Medokin8/Projekt_Zespolowy_Robot_Zwiadowczy/Konstruktorzy/Schematy/gąsienica.png

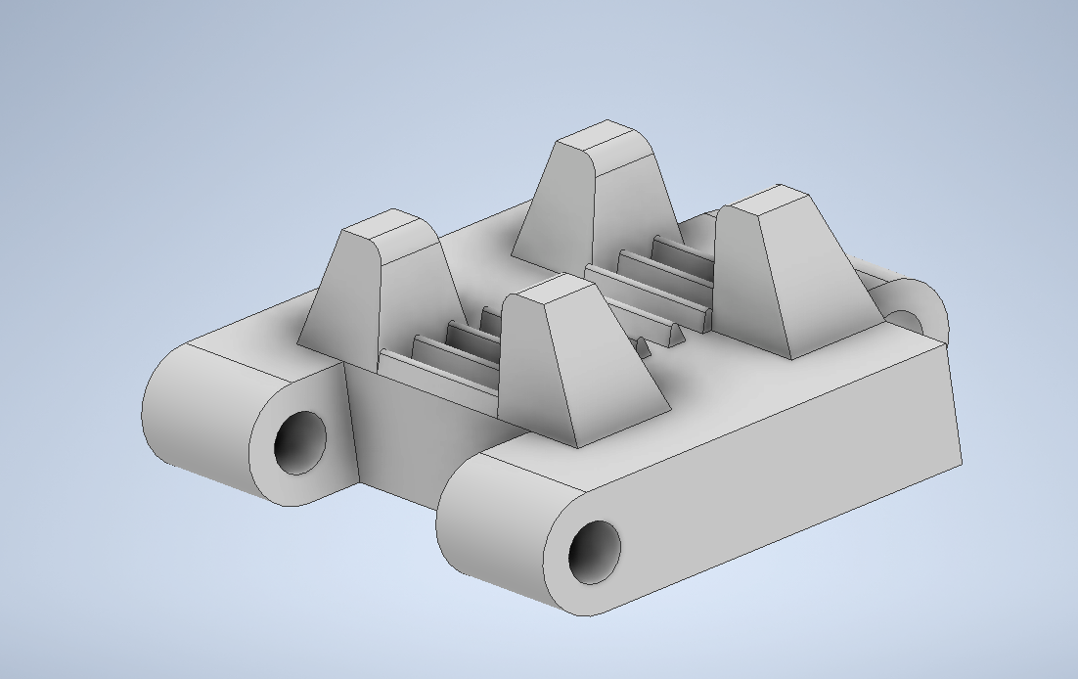
Konstruktorzy/Schematy/gąsienica.png
