Medokin8/Projekt_Zespolowy_Robot_Zwiadowczy/Konstruktorzy/Zdjęcia/gora.jpg

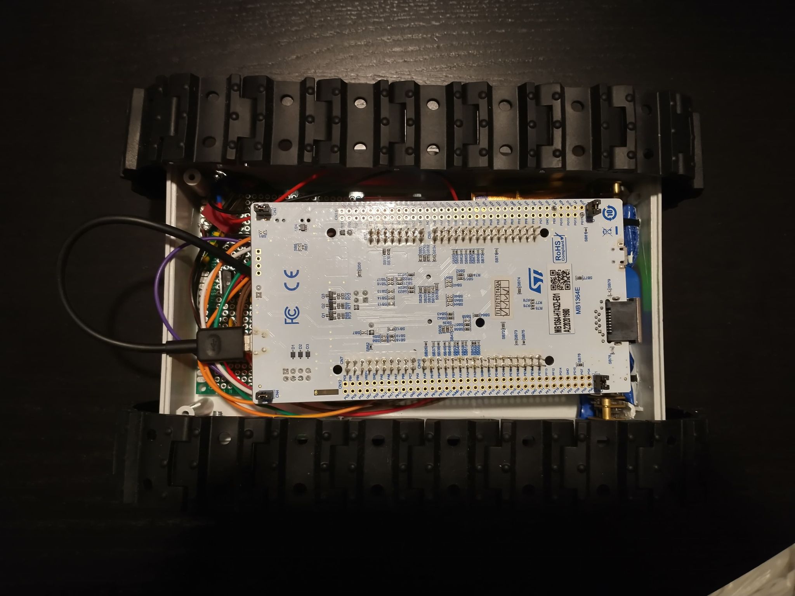
Konstruktorzy/Zdjęcia/gora.jpg
