Medokin8/Projekt_Zespolowy_Robot_Zwiadowczy/README.md

#Projekt_Zespolowy_Robot_Zwiadowczy
Repozytorium dla Projektu Zespołowego - Robot Zwiadowczy

Link do strony, poświęconej projektowi: http://panamint.kcir.pwr.edu.pl/~niwin/
