Medokin8/Projekt_Zespolowy_Robot_Zwiadowczy/Konstruktorzy/Raporty/raport_konstrukcja_1.pdf

Projekt zespołowy - Robot zwiadowczy

Sekcja konstrukcyjna

## Robot zwiadowczy - Pierwszy kamień milowy

(28.03.22)

Gerard Gawłowski, Nikodem Iwin

Prowadzący:
dr hab. inż Elżbieta Roszkowska

Katedra Cybernetyki i Robotyki Wydziału Elektroniki, Fotoniki i Mikrosystemów
Politechniki Wrocławskiej

27 marca 2022

## Spis treści

1 Charakterystyka kamienia milowego | 1
2 Specyfikacja finalnego produktu | 1
3 Zakup części | 3

i

## 1 Charakterystyka kamienia milowego

Pierwszym kamieniem milowym dla naszej sekcji było utworzenie prototypu strony internetowej i repozytorium na platformie GitHub poświęconej projektowi oraz zakup potrzebnych części do realizacji projektu.

## 2 Specyfikacja finalnego produktu

### 2.1 Prototyp strony WWW

Prototyp strony został napisany w języku HTML i wygląda jak na rysunku 1. Wraz z rozwojem projektu strona będzie ulegać zmianom i korektom.

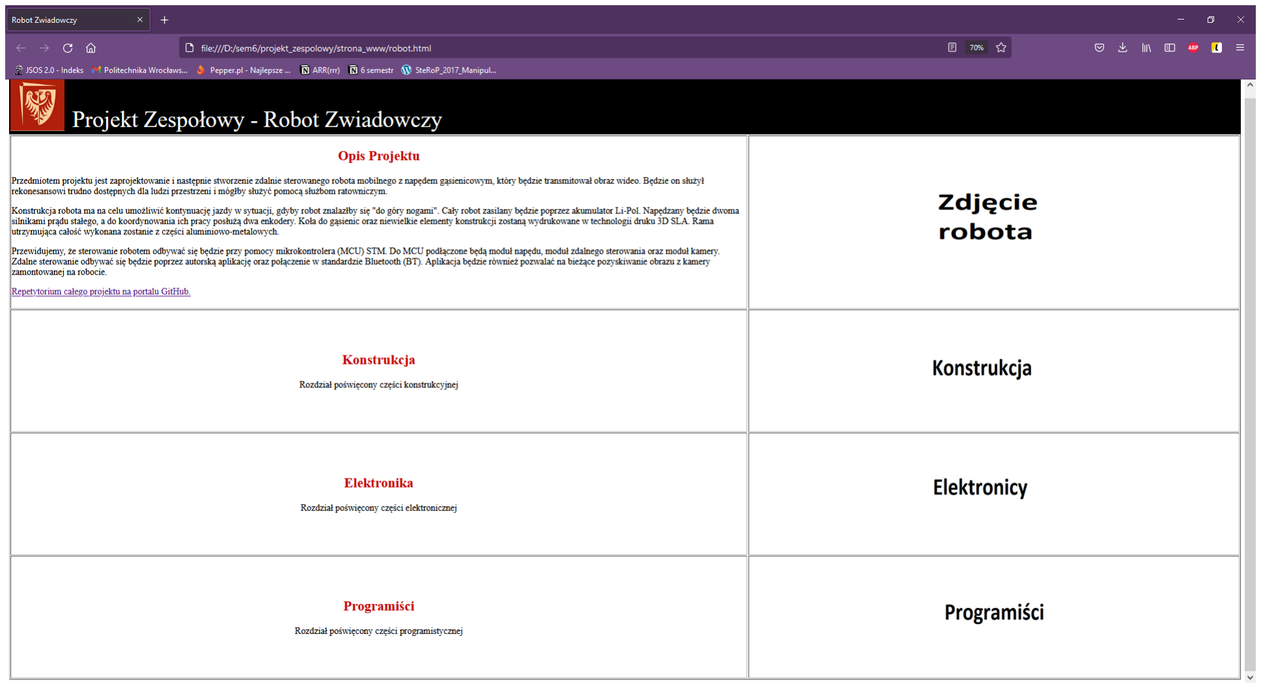
[picture p11: figure]

Rysunek 1: Prototyp strony WWW.

W zamyśle będzie to strona, która ogólnie przedstawi projekt w zakresie konstrukcji, elektorniki oraz programowania. Oprócz krótkich opisów oraz obrazów będzie również hiperłącze do repozytorium.

### 2.2 Repozytorium na platformie GitHub

Repozytorium na GitHub-ie zostało założone oraz podzielone kolejno na:

- main
- Elektronicy

– Oprogramowanie

– Raporty

– Schematy

– Zdjęcia

- Konstruktorzy

– Oprogramowanie

– Raporty

– Schematy

– Zdjęcia

- Programiści

– Oprogramowanie

– Raporty

– Schematy

– Zdjęcia

## 3 Zakup części

Zgodnie z ”Opisem Projektu” zostało złożone zamówienie na części, które zostały wy-kazane w poniższej tabeli numer 1. Obecnie oczekujemy an części, a po ich otrzymaniu rozpoczynamy dalsze prace.

Tabela kosztów
Przedmiot | ilość | cena netto (za sztukę) | cenna brutto (za sztukę) | sklep
Akumulator Li-Pol (https://botland.com.pl/akumulatory-li-pol-3s-111v-/8320-pakiet-li-pol-redox-900mah-20c-3s-111v-5903754000508.html) | 1 | 30,81 | 37,90 | Botland
Silniki (https://botland.com.pl/silniki-dc-micro-z-przekladnia/5097-silnik-hpcb-1501-obustronny-wal-pololu-3076-5904422306281.html) | 2 | 63,33 | 77,90 | Botland
Kamera (https://botland.com.pl/kamery-do-arduino-i-raspberry-pi/4937-modul-kamery-ov2640-2mpx-1622x1200px-60fps-waveshare-8532-5904422300388.html) | 1 | 47,15 | 58,00 | Botland
Gąsienice (https://botland.com.pl/makeblock-akcesoria/10560-makeblock-87050-gasienica-40szt-5904422316433.html) | 1 | 43,17 | 59,00 | Botland
Moduł Bluetooth (https://botland.com.pl/moduly-bluetooth/6818-modul-bluetooth-hc-06-zs-040.html) | 1 | 34,88 | 42,90 | Botland
Mikrokontorler STM32 (https://botland.com.pl/stm32-nucleo/3499-stm32-nucleo-f334r8-stm32f334r8t6-arm-cortex-m4-5904422364922.html) | 1 | 56,83 | 69,90 | Botland
Enkodery (https://botland.com.pl/enkodery/4884-zestaw-enkoderow-magnetycznych-do-micro-silnikow-pololu-kompatybilne-z-hpcb-27-18v-2-szt-pololu-3081-5904422309763.html) | 1 | 36,50 | 44,90 | Botland
Obudowa plastikowa (https://botland.com.pl/obudowy/5956-obudowa-plastikowa-kradex-z72j-179x102x49mm-jasna-5904422302177.html) | 1 | 13,74 | 16,90 | Botland
Cena łaczna | 389,74 | 485,30

Tabela 1: Tabela kosztów
