Medokin8/Projekt_Zespolowy_Robot_Zwiadowczy/Programisci/Raporty/raport_programisci_1.pdf

Projekt zespołowy - Robot zwiadowczy

Sekcja programistyczna

## Robot zwiadowczy - Pierwszy kamień milowy(28.03.2022)

Jacek Grzegorzewski, Dominik Polak

Prowadzący:
dr hab. inż Elżbieta Roszkowska

Katedra Cybernetyki i Robotyki Wydziału Elektroniki, Fotoniki i Mikrosystemów
Politechniki Wrocławskiej

28 marca 2022

## Spis treści

1 Charakterystyka kamienia milowego | 1
2 Specyfikacja finalnego produktu | 1

i

## 1 Charakterystyka kamienia milowego

Pierwszym kamieniem milowym dla naszej sekcji było stworzenie schematu do sprawozdań w Latexie.

## 2 Specyfikacja finalnego produktu

Schemat został stworzony w systemie Latex. Pierwsza strona została przedstawiona na rysunku 1, natomiast na stronie przedstawionej na rysunku2 został przedstawiony wstępny spis treści pokazujący co będzie zawierało dane sprawozdanie.

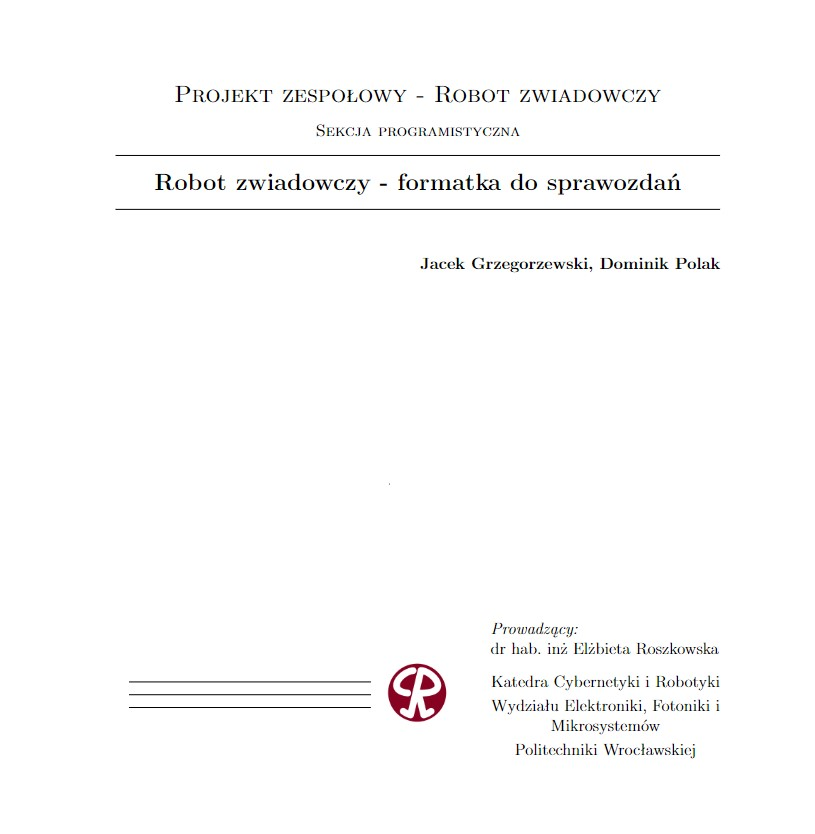
[picture p28: figure]

Rysunek 1: Strona główna sprawozdania

1

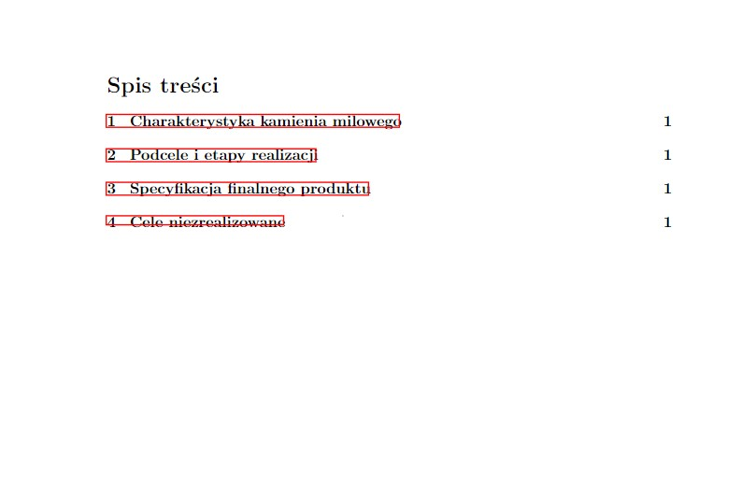
[picture p29: figure]

Rysunek 2: Strona 2, spis treści

## Literatura

2
