Medokin8/Projekt_Zespolowy_Robot_Zwiadowczy/Elektronicy/Zdjęcia/kod.png

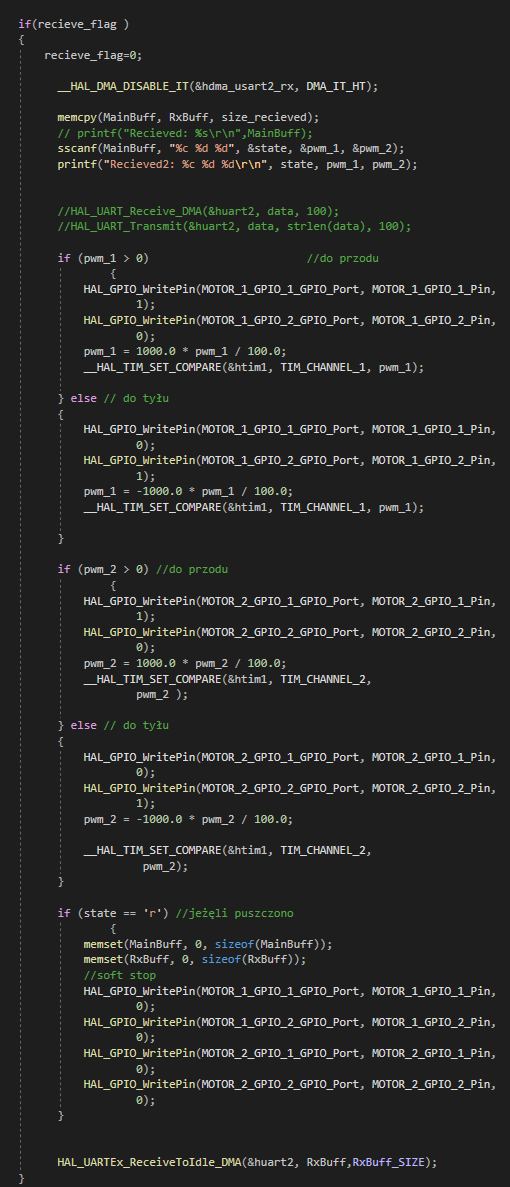
Elektronicy/Zdjęcia/kod.png
