Medokin8/Projekt_Zespolowy_Robot_Zwiadowczy/Elektronicy/Zdjęcia/schemat.png

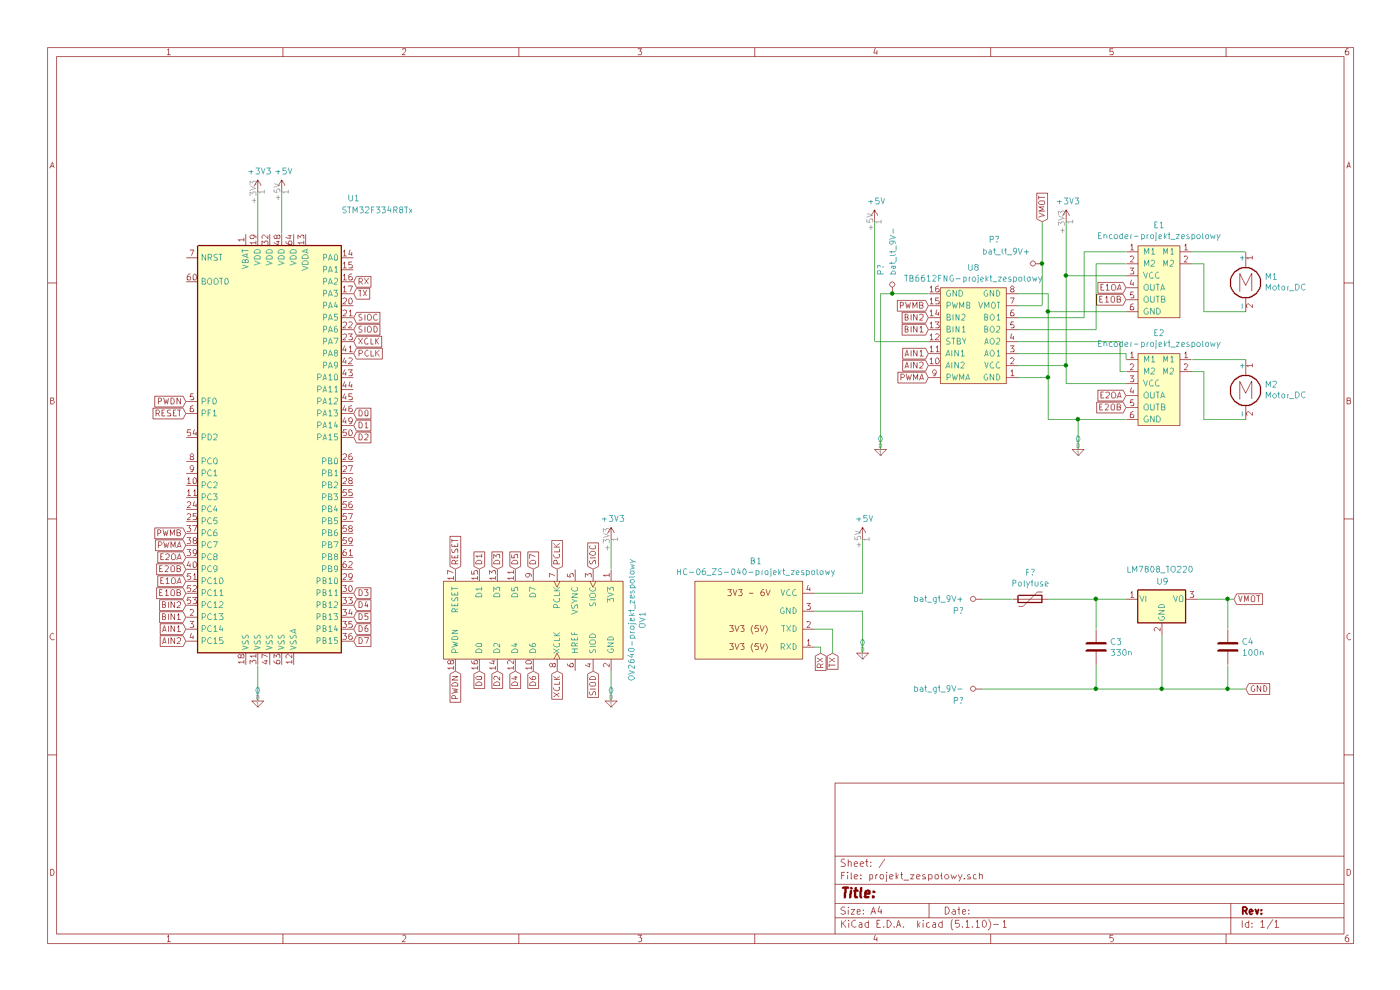
Elektronicy/Zdjęcia/schemat.png
