Medokin8/Projekt_Zespolowy_Robot_Zwiadowczy/Konstruktorzy/Schematy/kolo_napedowe_rysunek.png

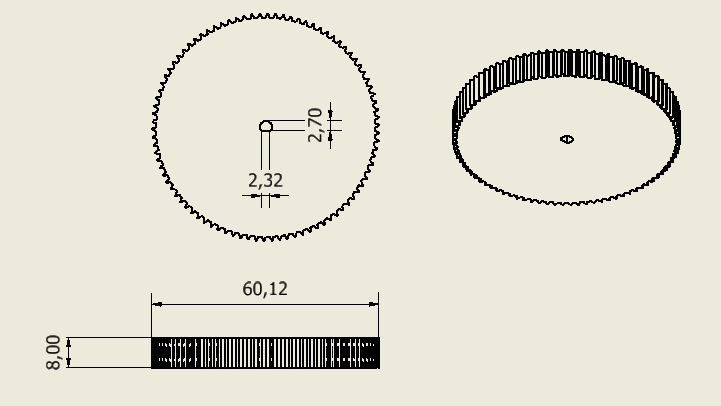
Konstruktorzy/Schematy/kolo_napedowe_rysunek.png
