Medokin8/Projekt_Zespolowy_Robot_Zwiadowczy/Konstruktorzy/Zdjęcia/284127700_5588591894509014_6389099319705223825_n.jpg

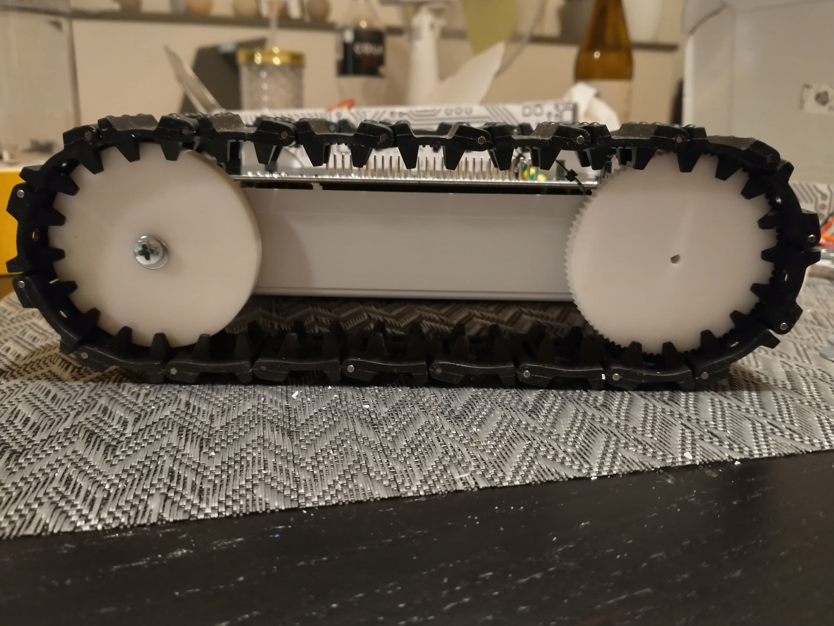
Konstruktorzy/Zdjęcia/284127700_5588591894509014_6389099319705223825_n.jpg
