Medokin8/Projekt_Zespolowy_Robot_Zwiadowczy/Konstruktorzy/Zdjęcia/284360030_1320538168766506_1794663341702950426_n.jpg

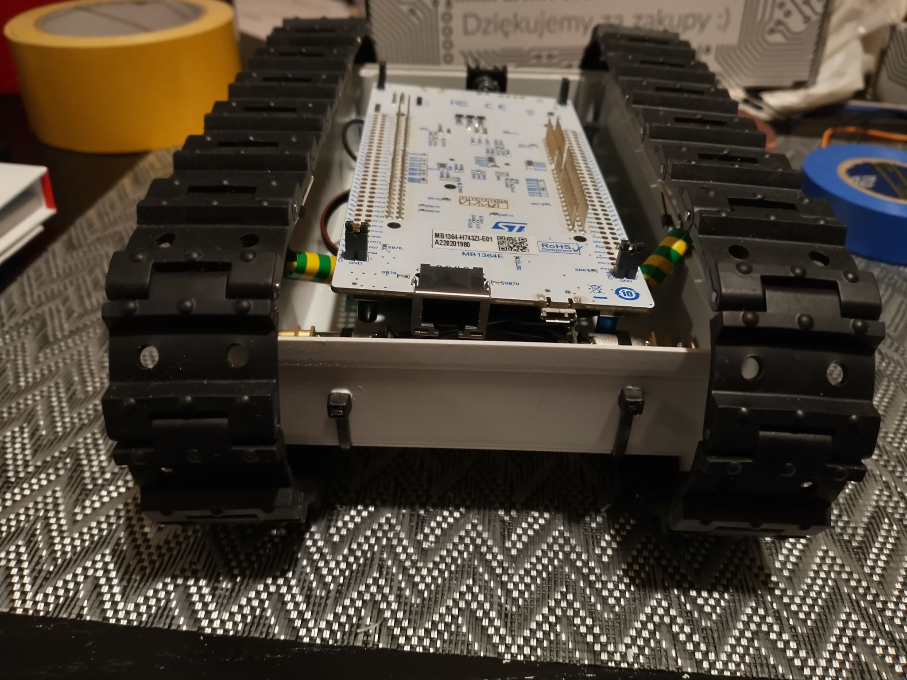
Konstruktorzy/Zdjęcia/284360030_1320538168766506_1794663341702950426_n.jpg
