Medokin8/Projekt_Zespolowy_Robot_Zwiadowczy/Konstruktorzy/Zdjęcia/284587400_364073168927964_801465958037753623_n.jpg

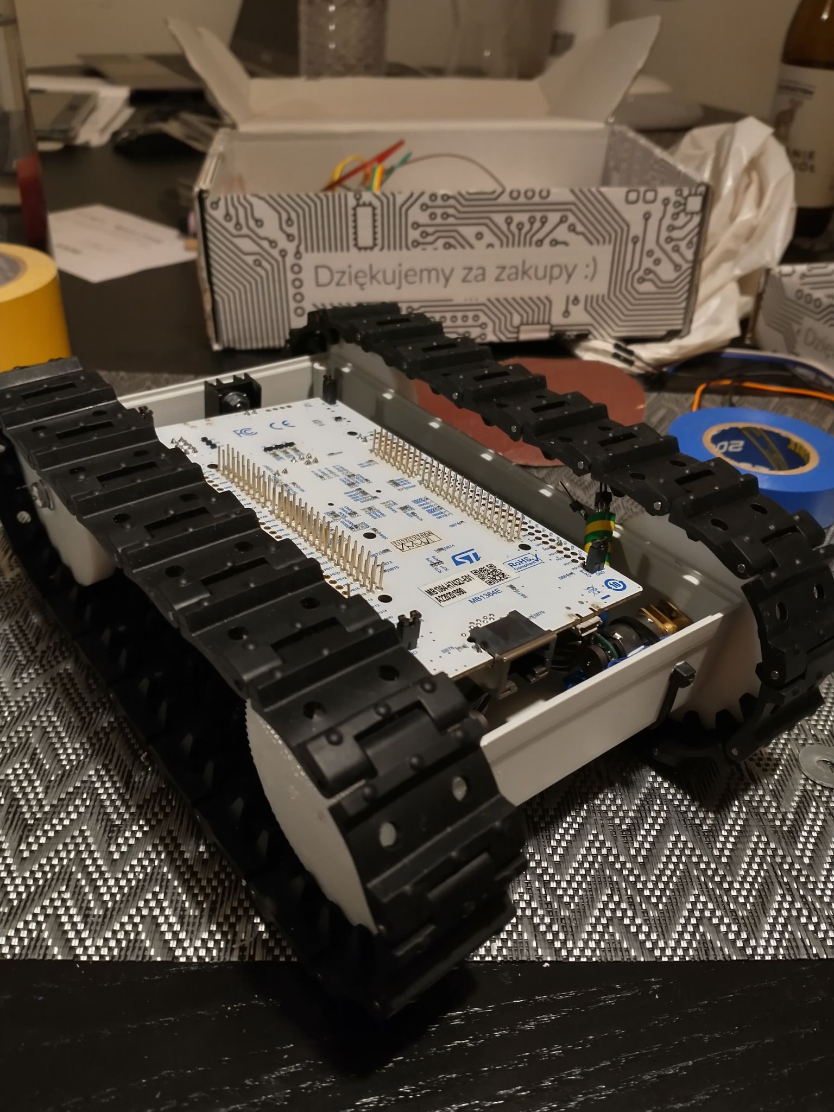
Konstruktorzy/Zdjęcia/284587400_364073168927964_801465958037753623_n.jpg
