Medokin8/Projekt_Zespolowy_Robot_Zwiadowczy/Konstruktorzy/Zdjęcia/bok.jpg

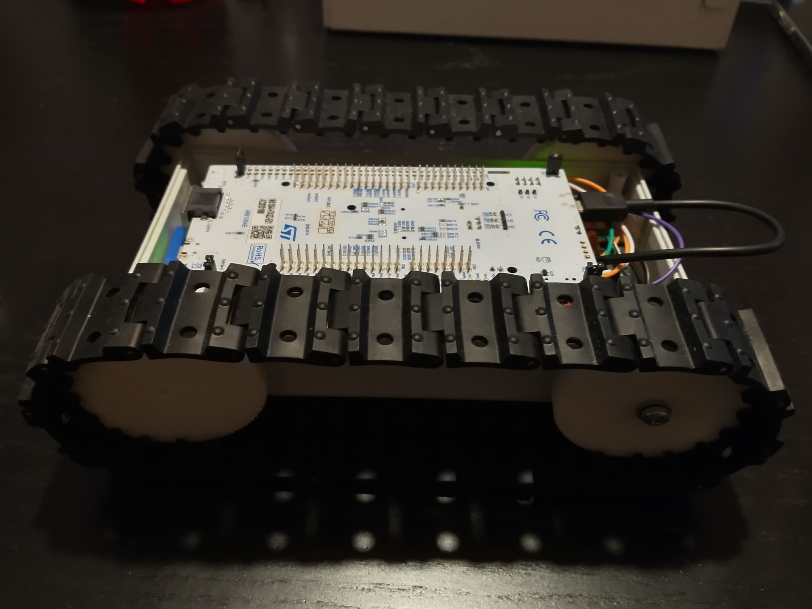
Konstruktorzy/Zdjęcia/bok.jpg
