Medokin8/Projekt_Zespolowy_Robot_Zwiadowczy/Konstruktorzy/Zdjęcia/budowa.jpg

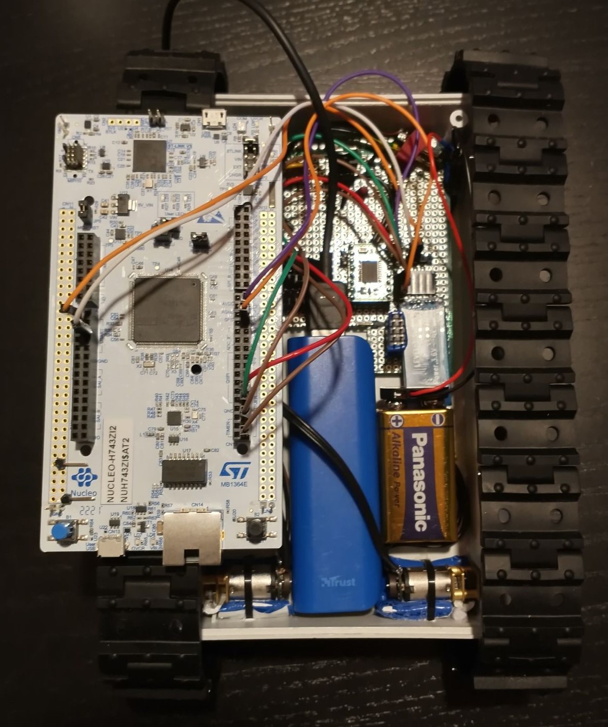
Konstruktorzy/Zdjęcia/budowa.jpg
