Medokin8/Projekt_Zespolowy_Robot_Zwiadowczy/Konstruktorzy/Zdjęcia/budowa_przed.jpg

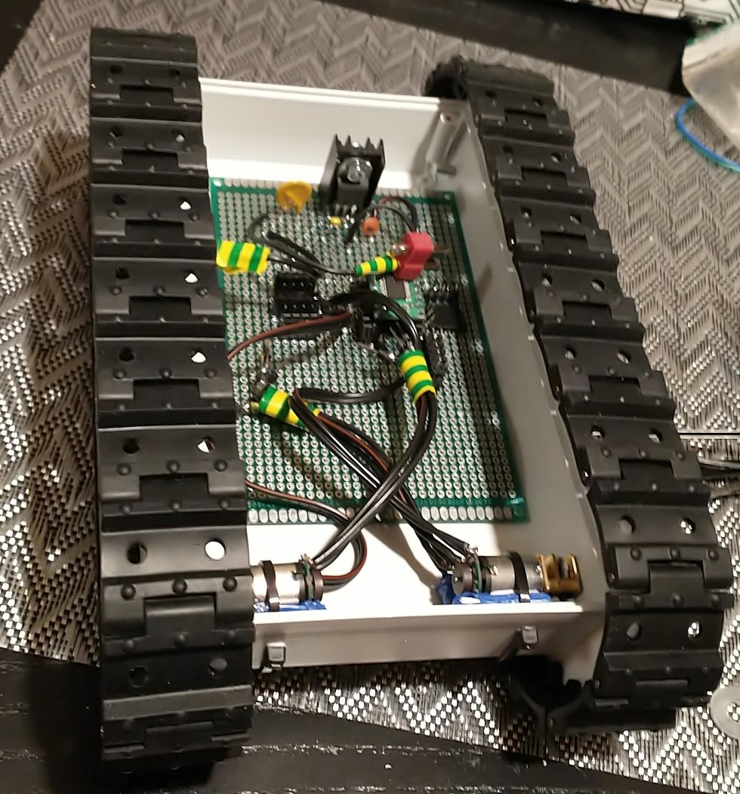
Konstruktorzy/Zdjęcia/budowa_przed.jpg
