Medokin8/Projekt_Zespolowy_Robot_Zwiadowczy/Konstruktorzy/Zdjęcia/płytka.jpg

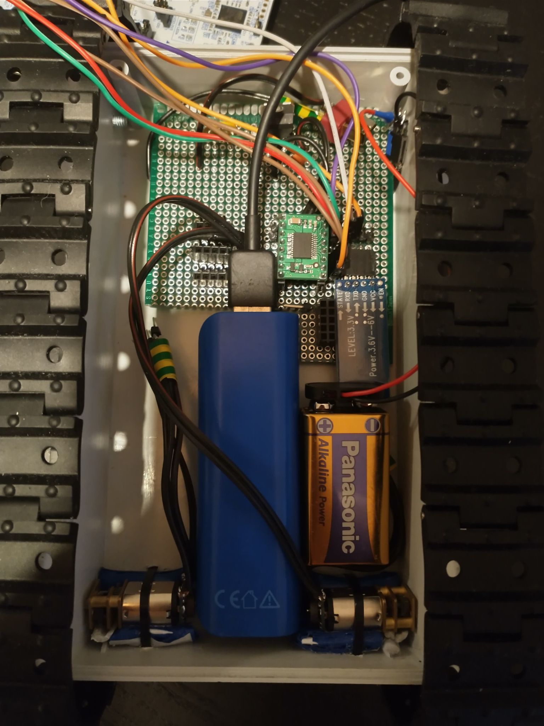
Konstruktorzy/Zdjęcia/płytka.jpg
