Medokin8/Projekt_Zespolowy_Robot_Zwiadowczy/Konstruktorzy/Zdjęcia/s1.PNG

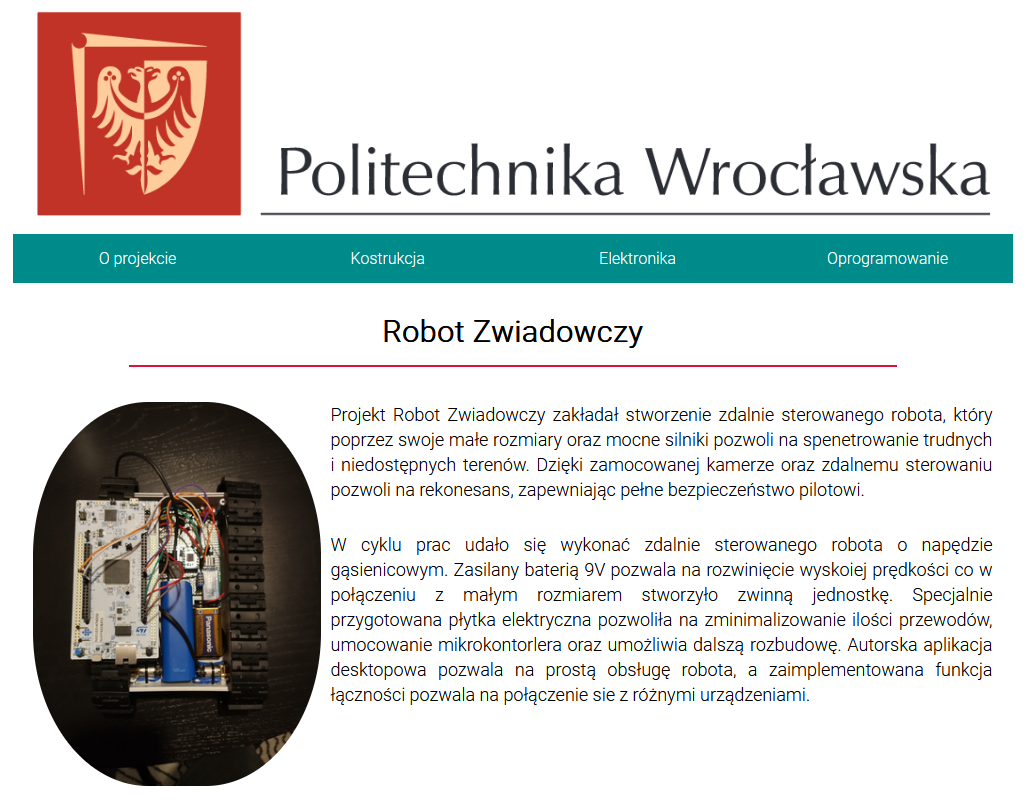
Konstruktorzy/Zdjęcia/s1.PNG
