Medokin8/Projekt_Zespolowy_Robot_Zwiadowczy/Konstruktorzy/Zdjęcia/s2.PNG

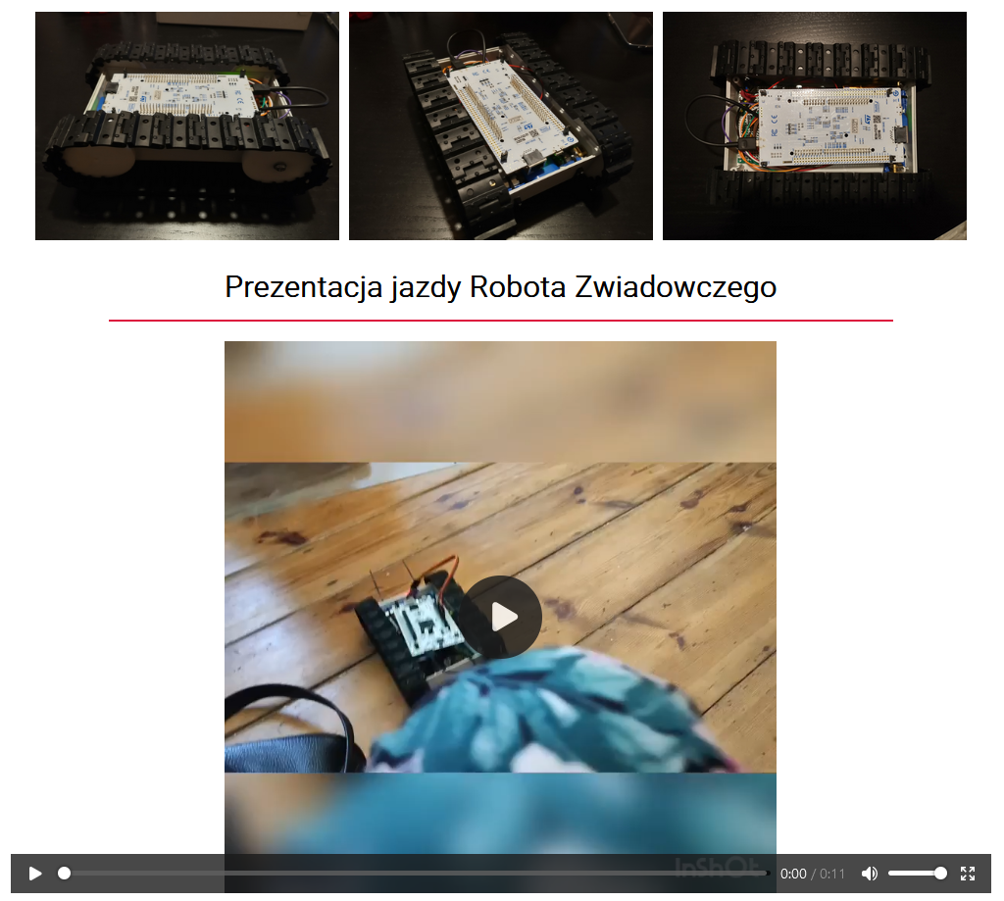
Konstruktorzy/Zdjęcia/s2.PNG
