Medokin8/Projekt_Zespolowy_Robot_Zwiadowczy/Konstruktorzy/Zdjęcia/s3.PNG

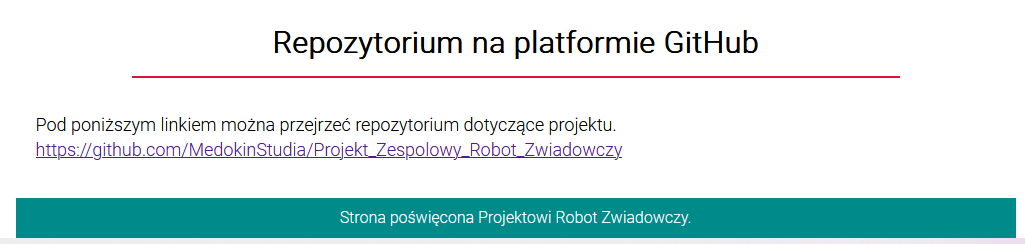
Konstruktorzy/Zdjęcia/s3.PNG
