Medokin8/Projekt_Zespolowy_Robot_Zwiadowczy/Konstruktorzy/Zdjęcia/s4.PNG

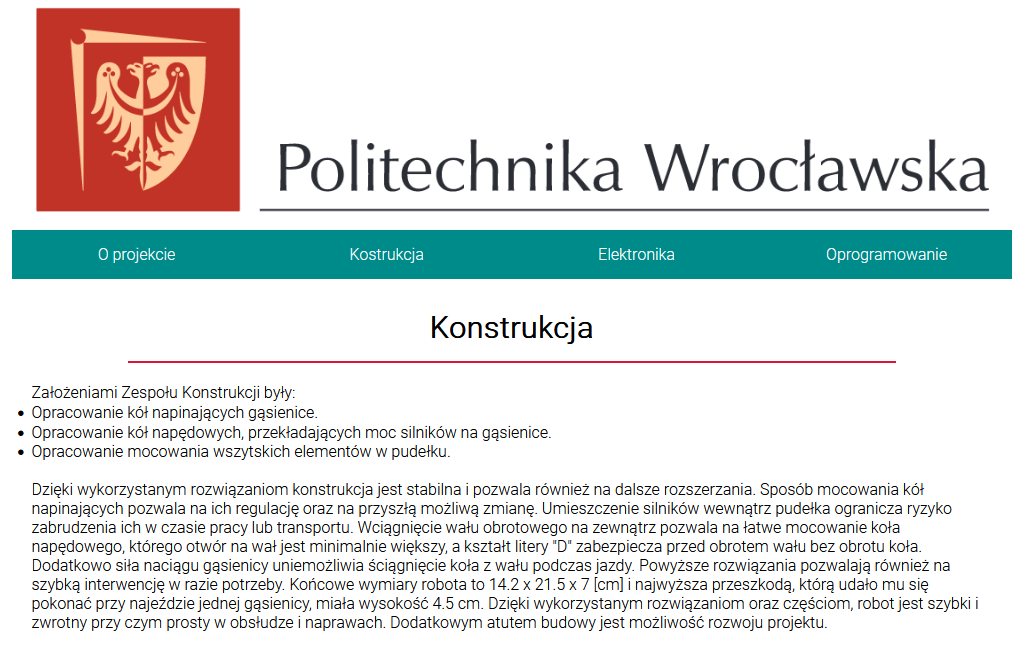
Konstruktorzy/Zdjęcia/s4.PNG
