Medokin8/Projekt_Zespolowy_Robot_Zwiadowczy/Konstruktorzy/Zdjęcia/s5.PNG

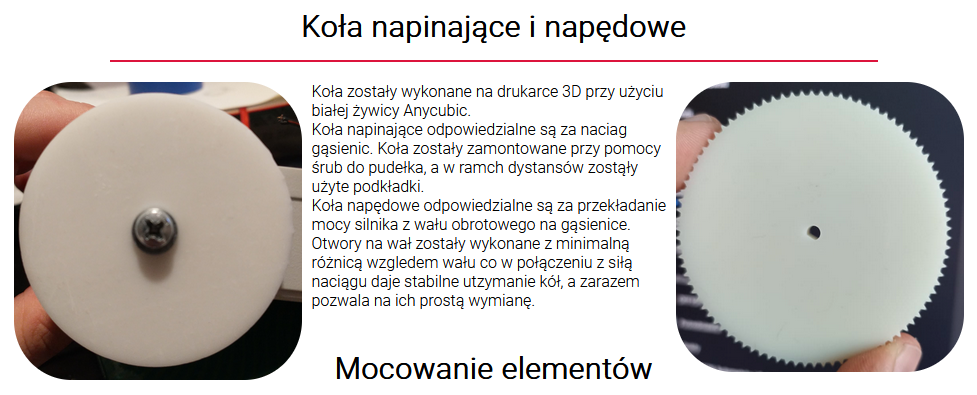
Konstruktorzy/Zdjęcia/s5.PNG
