Medokin8/Projekt_Zespolowy_Robot_Zwiadowczy/Konstruktorzy/Zdjęcia/s6.PNG

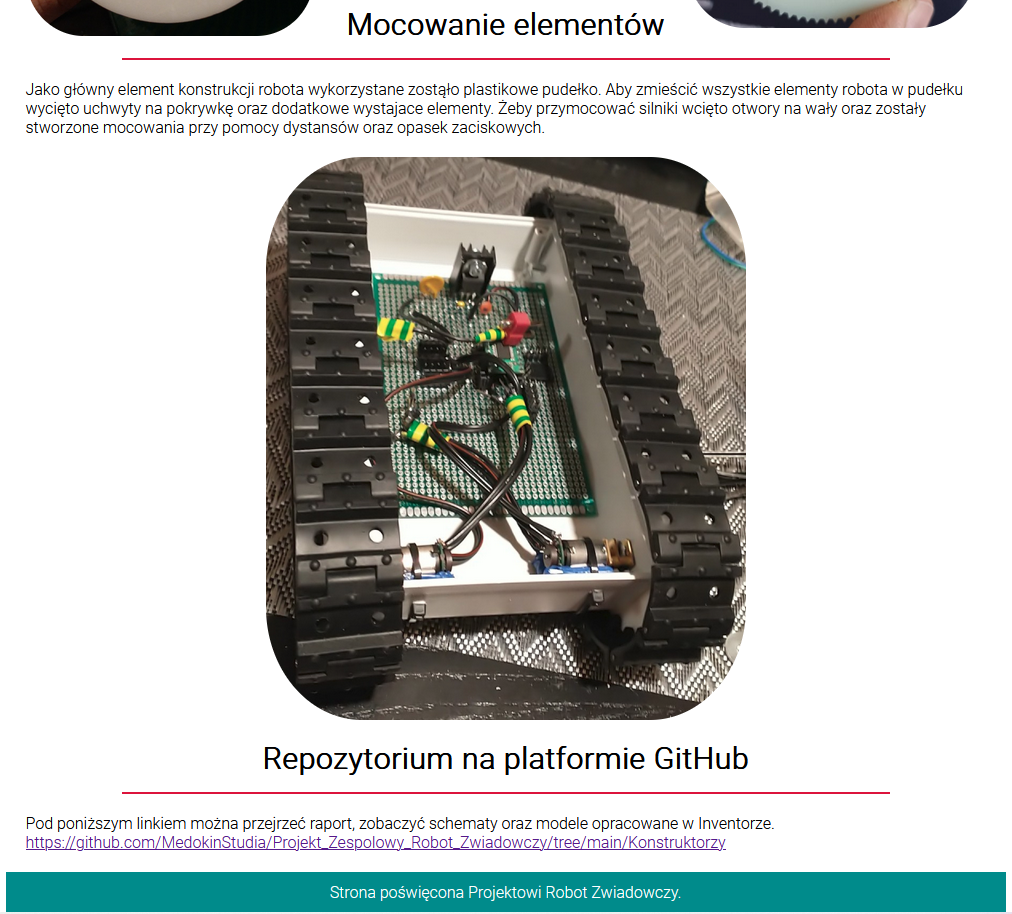
Konstruktorzy/Zdjęcia/s6.PNG
