Medokin8/Projekt_Zespolowy_Robot_Zwiadowczy/Konstruktorzy/Zdjęcia/s7.PNG

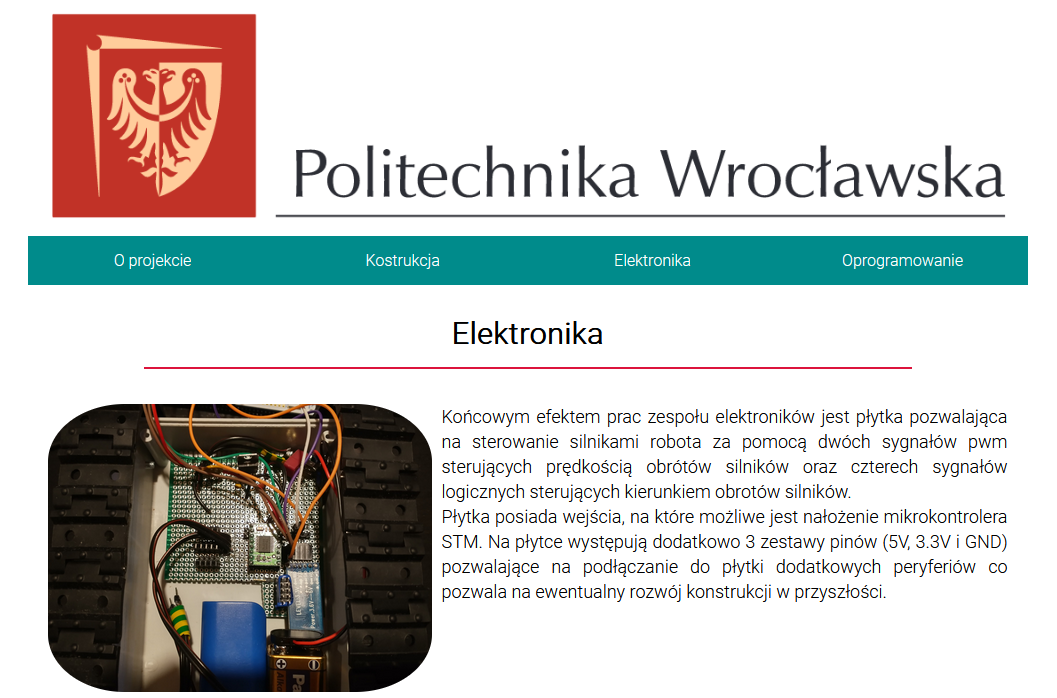
Konstruktorzy/Zdjęcia/s7.PNG
