Medokin8/Projekt_Zespolowy_Robot_Zwiadowczy/Konstruktorzy/Zdjęcia/s8.PNG

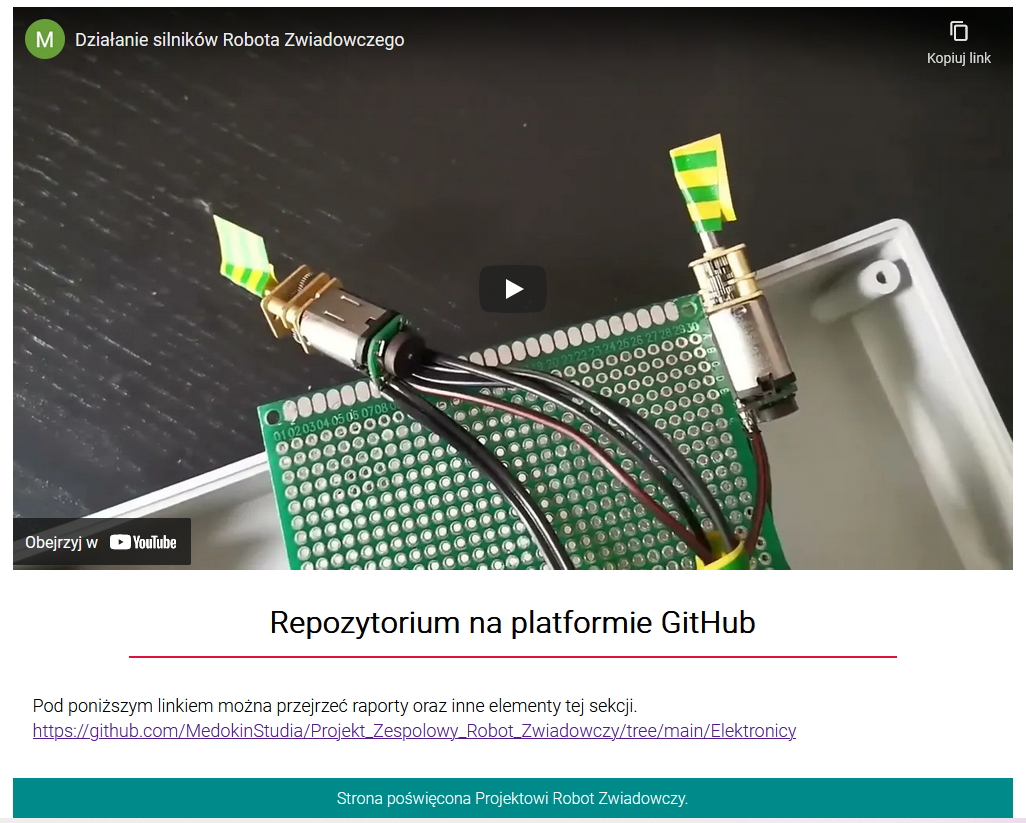
Konstruktorzy/Zdjęcia/s8.PNG
