Medokin8/Projekt_Zespolowy_Robot_Zwiadowczy/Konstruktorzy/Zdjęcia/s9.PNG

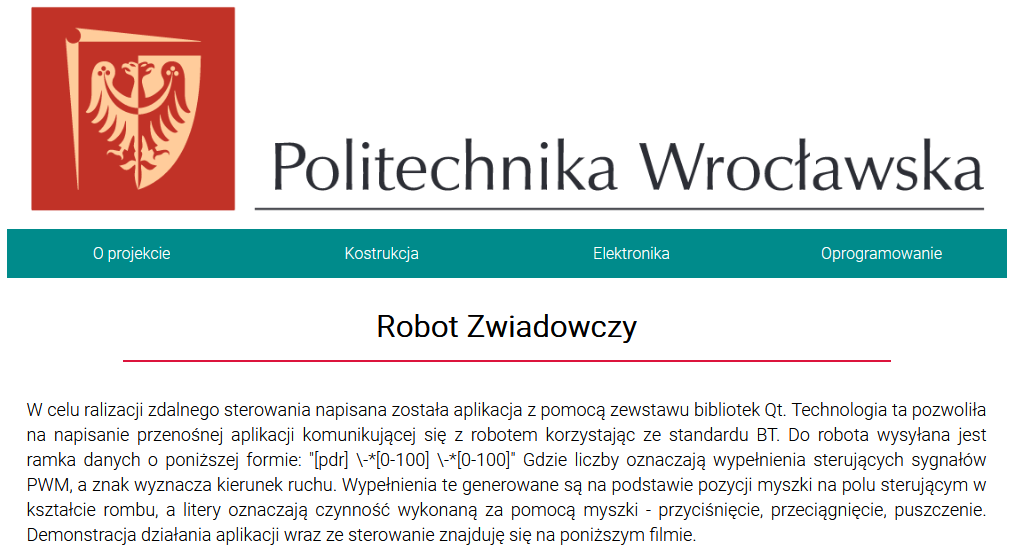
Konstruktorzy/Zdjęcia/s9.PNG
