Medokin8/Projekt_Zespolowy_Robot_Zwiadowczy/Konstruktorzy/Zdjęcia/s10.PNG

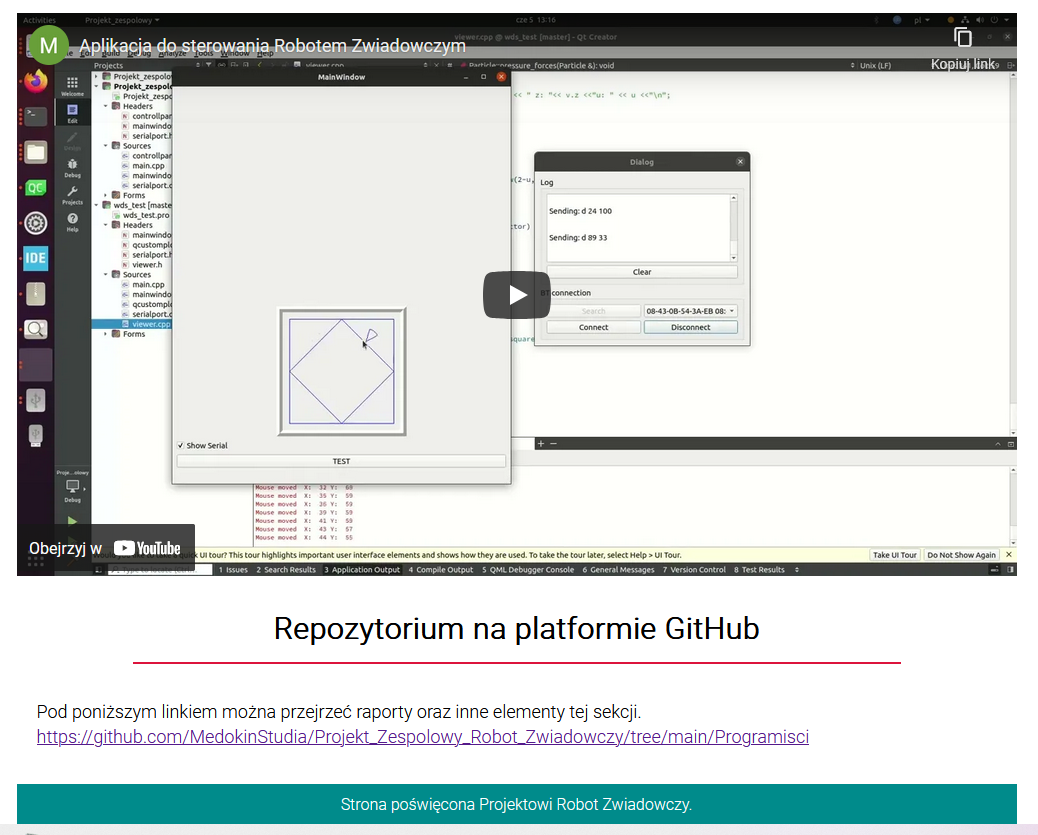
Konstruktorzy/Zdjęcia/s10.PNG
