Medokin8/Projekt_Zespolowy_Robot_Zwiadowczy/Konstruktorzy/Zdjęcia/ukos.jpg

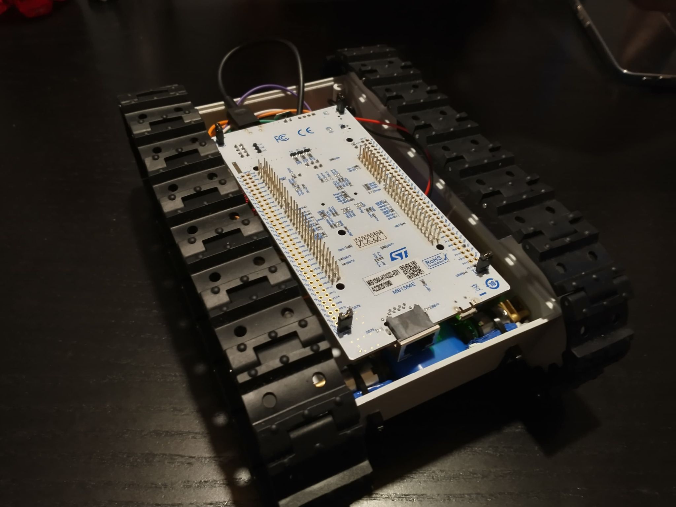
Konstruktorzy/Zdjęcia/ukos.jpg
