Medokin8/Projekt_Zespolowy_Robot_Zwiadowczy/Konstruktorzy/Zdjęcia/wyglad_z_boku.jpg

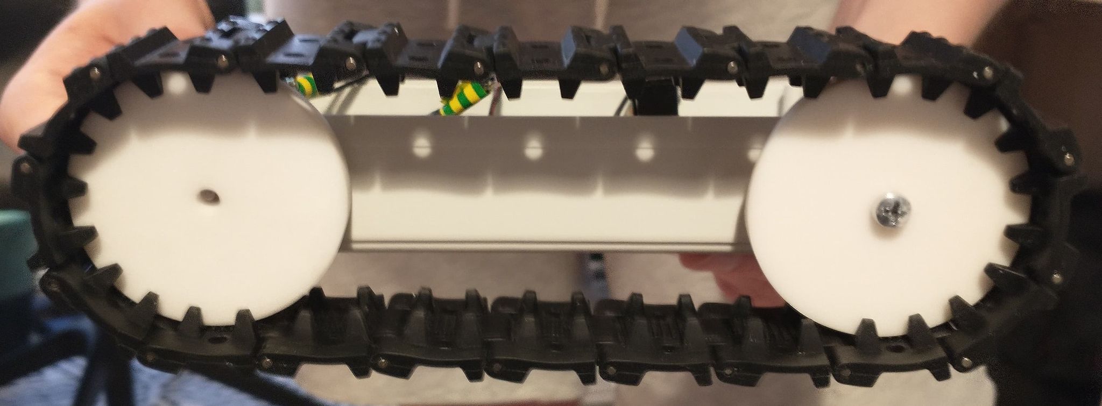
Konstruktorzy/Zdjęcia/wyglad_z_boku.jpg
