Medokin8/Projekt_Zespolowy_Robot_Zwiadowczy/Konstruktorzy/Zdjęcia/wyglad_z_gory.jpg

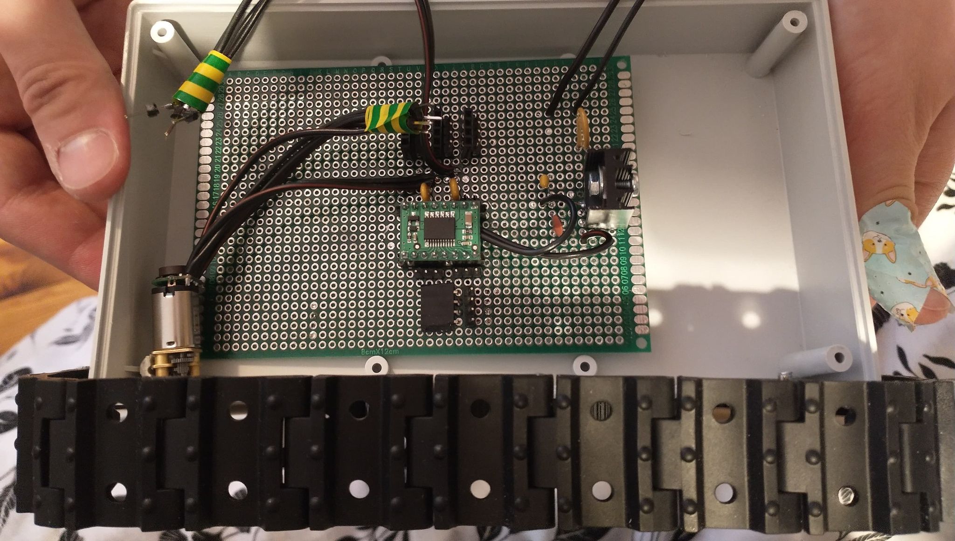
Konstruktorzy/Zdjęcia/wyglad_z_gory.jpg
