Medokin8/Projekt_Zespolowy_Robot_Zwiadowczy/public_html/budowa robota.jpg

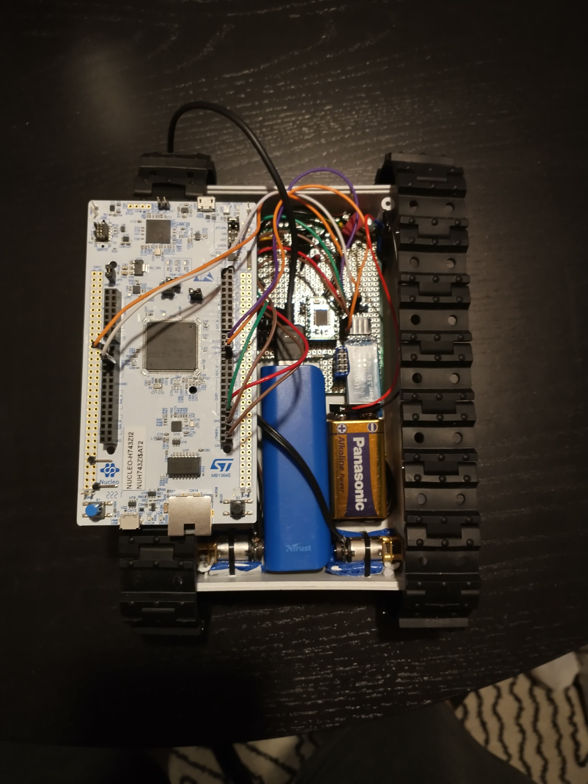
public_html/budowa robota.jpg
