Medokin8/Projekt_Zespolowy_Robot_Zwiadowczy/public_html/elektronika_1.png

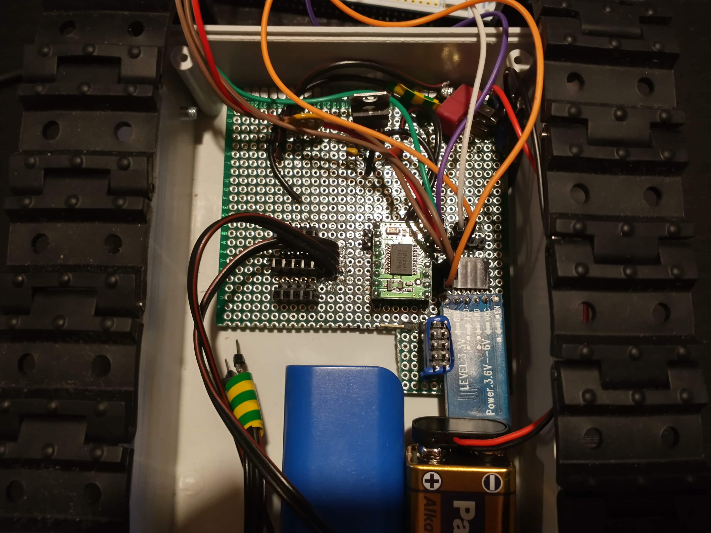
public_html/elektronika_1.png
