Medokin8/Projekt_Zespolowy_Robot_Zwiadowczy/public_html/kolo_napedowe_final.png

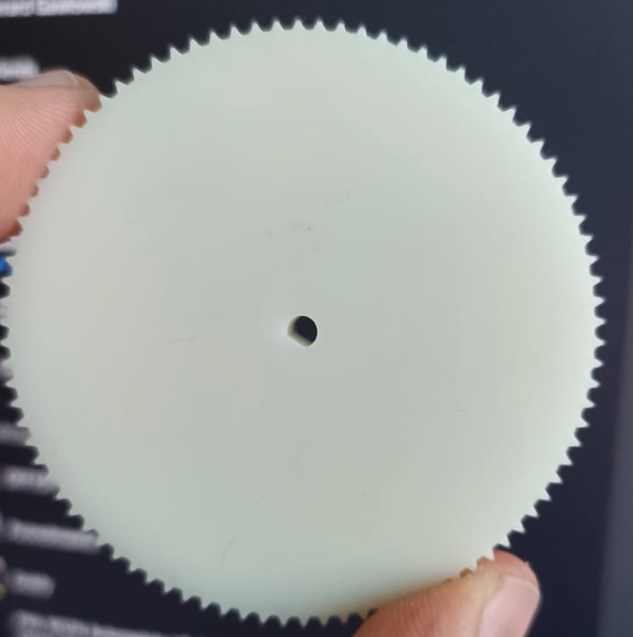
public_html/kolo_napedowe_final.png
