Medokin8/Projekt_Zespolowy_Robot_Zwiadowczy/public_html/prace_1_1.png

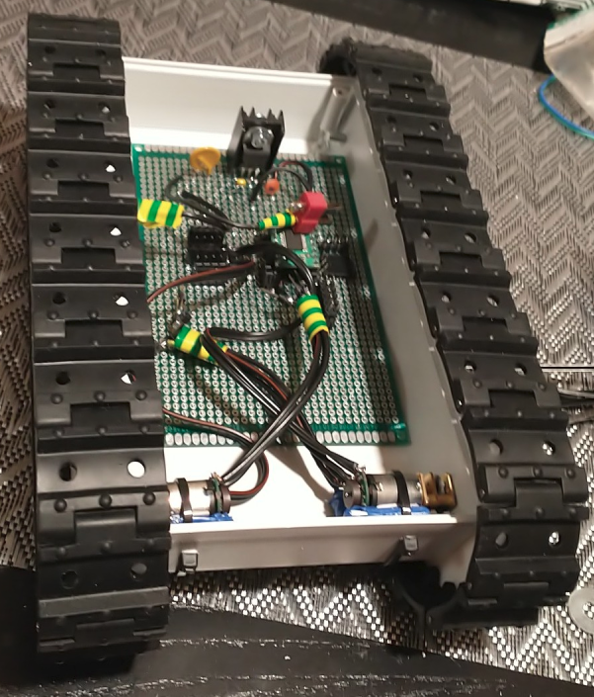
public_html/prace_1_1.png
