Medokin8/Projekt_Zespolowy_Robot_Zwiadowczy/(list of files, cad)

Other CAD files:
Konstruktorzy/Schematy/KOŁO.ipt
Konstruktorzy/Schematy/Koło napinające.ipt
Konstruktorzy/Schematy/Silniczek.ipt
Konstruktorzy/Schematy/Złożenie.iam
Konstruktorzy/Schematy/gasienica.ipt
Konstruktorzy/Schematy/pudelko dol.ipt
