Medokin8/Projekt_Zespolowy_Robot_Zwiadowczy/Elektronicy/projekt_zespołowy_schemat/projekt_zespołowy.kicad_pcb

## KiCad design Elektronicy/projekt_zespołowy_schemat/projekt_zespołowy.kicad_pcb (2022-06-05)

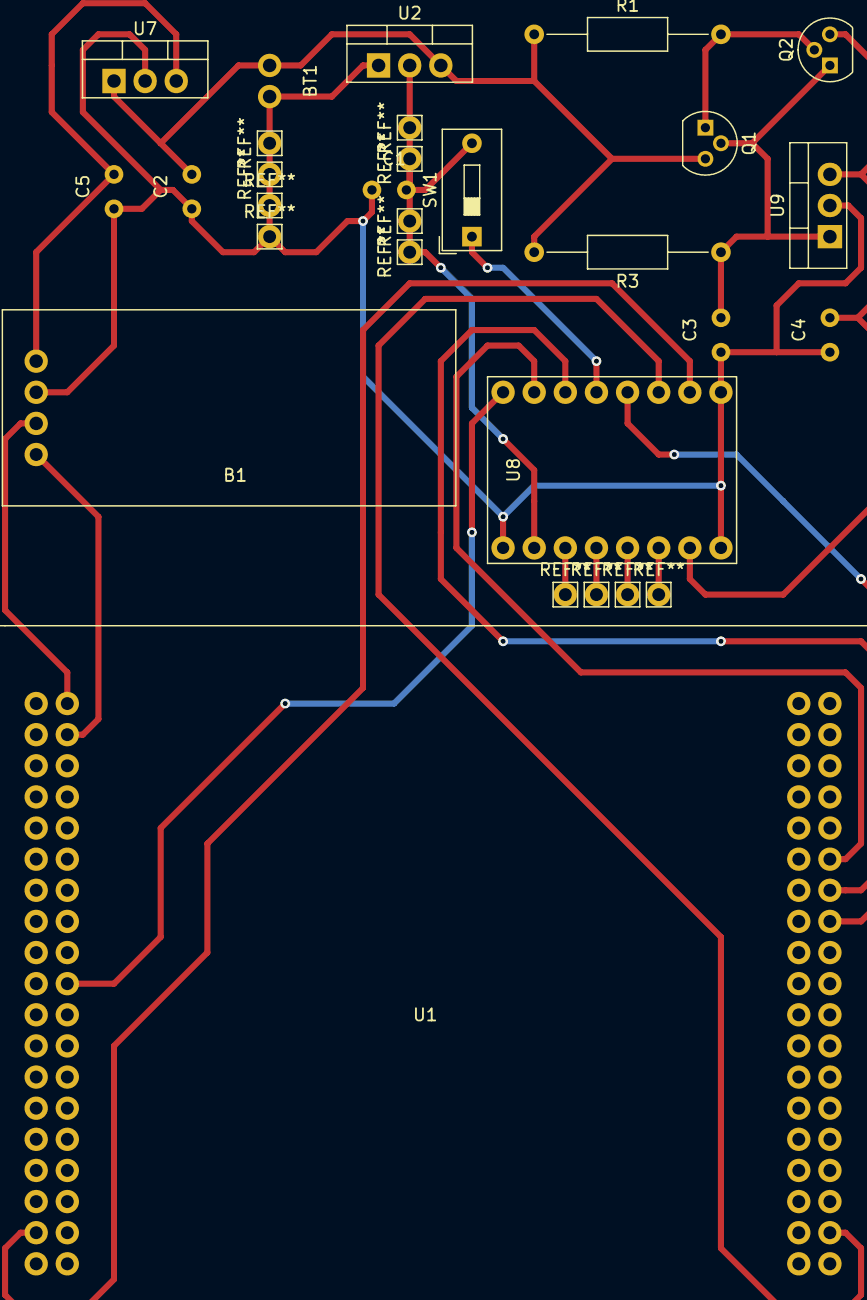
[picture p57: board projekt_zespołowy.kicad_pcb from above]

Board: 2 copper layers, 17 parts (0 on the bottom side), 16 nets.

Parts:
B1: HC-06_ZS-040-projekt_zespolowy; HC-06_ZS-040
BT1: Battery_Cell; bat
C1, C4, C5: 100n; C
C2, C3: 330n; C
Q1, Q2: Q_PNP_BCE; TO-92
R1: 15m; R_Axial_DIN0207_L6.3mm_D2.5mm_P15.24mm_Horizontal
R3: 3; R_Axial_DIN0207_L6.3mm_D2.5mm_P15.24mm_Horizontal
SW1: SW_DIP_x01; SW_DIP_SPSTx01_Slide_9.78x4.72mm_W7.62mm_P2.54mm
U1: STM32F334R8Tx; stm32f334R8
U2: LD1117S33TR_SOT223; TO-220-3_Vertical
U7: L7805; TO-220-3_Vertical
U8: TB6612FNG-projekt_zespolowy; TB6612FNG
U9: LM7808_TO220; TO-220-3_Vertical

Connections:
+3V3: C1.1, SW1.2, U2.2, U8.2
AIN1: U1.3, U8.11
AIN2: U1.4, U8.10
BIN1: U1.2, U8.13
BIN2: U1.53, U8.14
GND: B1.3, BT1.2, C1.2, C2.2, C3.2, C4.2, C5.2, U2.1, U7.2, U8.1, U8.8, U8.16, U9.2
unnamed: C3.1, Q1.2, Q2.1, R3.1, U9.1
unnamed: Q1.1, Q2.2, R1.2
PWMA: U1.38, U8.9
PWMB: U1.37, U8.15
RX: B1.1, U1.16
STBY: SW1.1, U8.12
TX: B1.2, U1.17
VCC: B1.4, C5.1, U7.3
VMOT: BT1.1, C2.1, Q1.3, R1.1, R3.2, U2.3, U7.1
VMOTS: C4.1, Q2.3, U8.7, U9.3
