Medokin8/Projekt_Zespolowy_Robot_Zwiadowczy/Programisci/ProjektZespolowy/Core/Src/main.c

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
/* Includes ------------------------------------------------------------------*/
#include "main.h"

/* USER CODE BEGIN Includes */
#include "camera.h"
#include "string.h"
#include "stdio.h"
/* USER CODE END Includes */

/* USER CODE BEGIN PTD */
#define RxBuff_SIZE 64
#define MainBuf_SIZE 128

uint8_t MainBuff[MainBuf_SIZE];
uint8_t RxBuff[RxBuff_SIZE];

/* USER CODE END PTD */

/* USER CODE BEGIN PD */
#define RES320x240
//#define RES800x600
//#define RES1024x768
//#define RES1280x960

/* USER CODE END PD */


DCMI_HandleTypeDef hdcmi;
DMA_HandleTypeDef hdma_dcmi;

I2C_HandleTypeDef hi2c1;

JPEG_HandleTypeDef hjpeg;

TIM_HandleTypeDef htim1;

UART_HandleTypeDef huart2;
UART_HandleTypeDef huart3;
DMA_HandleTypeDef hdma_usart2_rx;
DMA_HandleTypeDef hdma_usart3_tx;

/* USER CODE BEGIN PV */
#ifdef RES320x240
enum imgResolution imgRes = RES_320x240;
uint8_t imgFrameBuffer[15534] = {0};
#endif

#ifdef RES800x600
enum imgResolution imgRes = RES_800x600;
uint8_t imgFrameBuffer[] = {0};
#endif

#ifdef RES1024x768
enum imgResolution imgRes = RES_1024x768;
uint8_t imgFrameBuffer[] = {0};
#endif

#ifdef RES1280x960
enum imgResolution imgRes = RES_1280x960;
uint8_t imgFrameBuffer[] = {0};
#endif

uint32_t mutex = 0;
uint16_t imgBufferPointer = 0;
uint16_t imgHeaderFound = 0;
volatile uint16_t recieve_flag=0;
volatile uint16_t size_recieved=0;
/* USER CODE END PV */

void SystemClock_Config(void);
static void MX_GPIO_Init(void);
static void MX_DMA_Init(void);
static void MX_USART3_UART_Init(void);
static void MX_DCMI_Init(void);
static void MX_I2C1_Init(void);
static void MX_JPEG_Init(void);
static void MX_USART2_UART_Init(void);
static void MX_TIM1_Init(void);
/* USER CODE BEGIN PFP */
uint8_t data;
/* USER CODE END PFP */

/* USER CODE BEGIN 0 */
/*
void HAL_UART_RxCpltCallback(UART_HandleTypeDef * uart) {
	if (uart == &huart2) {
		//frame_parser_recv_char(&frame_parser_handler, recv_char);
		recieve_flag = 1;
		HAL_UART_Transmit_IT(uart, data, 1);
		HAL_UART_Receive_IT(&huart2, data, 1);
	}
}
*/

int _write(int file, unsigned char *ptr, int len){
	HAL_UART_Transmit(&huart2, ptr, len, HAL_MAX_DELAY);
	return len;
}
/* USER CODE END 0 */

/**
  * @brief  The application entry point.
  * @retval int
  */
int main(void)
{
  /* MCU Configuration--------------------------------------------------------*/

  /* Reset of all peripherals, Initializes the Flash interface and the Systick. */
  HAL_Init();

  /* Configure the system clock */
  SystemClock_Config();

  /* Initialize all configured peripherals */
  MX_GPIO_Init();
  MX_DMA_Init();
  MX_USART3_UART_Init();
  MX_DCMI_Init();
  MX_I2C1_Init();
  MX_JPEG_Init();
  MX_USART2_UART_Init();
  MX_TIM1_Init();
  /* USER CODE BEGIN 2 */

  camera_setUART(&huart2);
  camera_Init(&hi2c1, &hdcmi);
  HAL_Delay(10);

  HAL_TIM_Base_Start(&htim1);
  //camera_ResolutionConfiguration(imgRes);
  //camera_configuration(OV2640_QVGA);
  HAL_Delay(10);
  HAL_UARTEx_ReceiveToIdle_DMA(&huart2,RxBuff,RxBuff_SIZE);
  __HAL_DMA_DISABLE_IT(&hdma_usart2_rx, DMA_IT_HT);

  HAL_UART_Transmit(&huart2, (uint8_t*)"Koniec\n\r", strlen("Koniec\n\r"), 100);


  int pwm_1=0;
  int pwm_2 =0;
  char state = 0;
  /* USER CODE END 2 */

  /* Infinite loop */
  /* USER CODE BEGIN WHILE */
  while (1)
  {

/*
    # forward = 1 backward = 0 => do przodu
    #
    # 0 1 => do tylu
    #
    # 0 0 => 'soft stop'
    #
    # 1 1 => tylko zmiana predkosci
    #
    # WAZNE predkosc z zakresu 0 - 100 [%]
    #
    # pwm wypelniane %
    # pi_pwm1.ChangeDutyCycle(speed)
	*/

	  if(recieve_flag)
	  {
		  recieve_flag=0;

		  memcpy(MainBuff,RxBuff,size_recieved);
		  HAL_UARTEx_ReceiveToIdle_DMA(&huart2,RxBuff,RxBuff_SIZE);
		   __HAL_DMA_DISABLE_IT(&hdma_usart2_rx,DMA_IT_HT);
		  //HAL_UART_Receive_DMA(&huart2, data, 100);
		  //HAL_UART_Transmit(&huart2, data, strlen(data), 100);

		  printf("Recieved: %s\r\n",MainBuff);
		  //sscanf(MainBuff,"%c %d %d",&state,&pwm_1,&pwm_2);
		  //memcpy(MainBuff,0,size_recieved);

		 // printf("Recieved2: %c %d %d\r\n",state,pwm_1,pwm_2);


		  if(pwm_1>0)//do przodu
		  {
			  HAL_GPIO_WritePin(MOTOR_1_GPIO_1_GPIO_Port, MOTOR_1_GPIO_1_Pin,	1);
			  HAL_GPIO_WritePin(MOTOR_1_GPIO_2_GPIO_Port, MOTOR_1_GPIO_2_Pin,	0);

			  __HAL_TIM_SET_COMPARE(&htim1, TIM_CHANNEL_1, 1000.0*pwm_1/100.0);

		  }else // do tyłu
		  {
			  HAL_GPIO_WritePin(MOTOR_1_GPIO_1_GPIO_Port, MOTOR_1_GPIO_1_Pin,	0);
			  HAL_GPIO_WritePin(MOTOR_1_GPIO_2_GPIO_Port, MOTOR_1_GPIO_2_Pin,	1);

			  __HAL_TIM_SET_COMPARE(&htim1, TIM_CHANNEL_1, -1000.0*pwm_1/100.0);

		  }

		  if(pwm_2>0)//do przodu
		  {
			  HAL_GPIO_WritePin(MOTOR_2_GPIO_1_GPIO_Port,  MOTOR_2_GPIO_1_Pin,	1);
			  HAL_GPIO_WritePin(MOTOR_2_GPIO_2_GPIO_Port, MOTOR_2_GPIO_2_Pin,	0);

			  __HAL_TIM_SET_COMPARE(&htim1, TIM_CHANNEL_2, 1000.0*pwm_2/100.0);

		   }else // do tyłu
		   {
				  HAL_GPIO_WritePin(MOTOR_2_GPIO_1_GPIO_Port, MOTOR_2_GPIO_1_Pin,	0);
				  HAL_GPIO_WritePin(MOTOR_2_GPIO_2_GPIO_Port, MOTOR_2_GPIO_2_Pin,	1);

				  __HAL_TIM_SET_COMPARE(&htim1, TIM_CHANNEL_2, -1000.0*pwm_2/100.0);
		   }
		  if(state == 'r')//jeżęli puszczono
		  {

			  //soft stop
			  HAL_GPIO_WritePin(MOTOR_1_GPIO_1_GPIO_Port, MOTOR_1_GPIO_1_Pin,	0);
			  HAL_GPIO_WritePin(MOTOR_1_GPIO_2_GPIO_Port, MOTOR_1_GPIO_2_Pin,	0);
			  HAL_GPIO_WritePin(MOTOR_2_GPIO_1_GPIO_Port, MOTOR_2_GPIO_1_Pin,	0);
			  HAL_GPIO_WritePin(MOTOR_2_GPIO_2_GPIO_Port, MOTOR_2_GPIO_2_Pin,	0);

		  }
	  }
	  /*if(HAL_GPIO_ReadPin(B1_GPIO_Port, B1_Pin)){
		  //HAL_UART_Transmit(&huart2, (uint8_t*)"Przycisk", strlen("Przycisk"), 100);
		  //HAL_UART_Transmit(huart, pData, Size, Timeout)
		  camera_CaptureSnapshot();
		  //camera_CaptureContinuous();
	  }*/
	  /*if(HAL_GPIO_ReadPin(B1_GPIO_Port, B1_Pin)){
		  if(mutex == 1){
			  HAL_DCMI_Stop(&hdcmi);
			  memset(imgFrameBuffer, 0, sizeof imgFrameBuffer);
			  //camera_CaptureSnapshot((uint32_t) imgFrameBuffer, 15534);
			  HAL_DCMI_Start_DMA(&hdcmi, DCMI_MODE_SNAPSHOT, (uint32_t)imgFrameBuffer, 65535/4);
			  //HAL_UART_Transmit_DMA(&huart2, imgFrameBuffer, 15534)
			  while(1)
			  {
				  if(imgHeaderFound == 0 && imgFrameBuffer[imgBufferPointer] == 0xFF
						  && imgFrameBuffer[imgBufferPointer+1] == 0xD8){
					  imgHeaderFound = 1;
				  }

				  if(imgHeaderFound == 1 && imgFrameBuffer[imgBufferPointer] == 0xFF
				 						  && imgFrameBuffer[imgBufferPointer+1] == 0xD9){
					  imgBufferPointer += 2;
					  imgHeaderFound = 0;
					  break;
				  }

				  if(imgBufferPointer >= 65535){
					  break;
				  }
				  imgBufferPointer++;
			  }
			  HAL_UART_Transmit_DMA(&huart2, imgFrameBuffer, imgBufferPointer);
			  imgBufferPointer = 0;
			  mutex = 0;
		  }
	  }else{
		  mutex = 1;
	  }*/
    /* USER CODE END WHILE */

    /* USER CODE BEGIN 3 */
  }
  /* USER CODE END 3 */
}

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
/* USER CODE BEGIN 4 */
void HAL_UARTEx_RxEventCallback(UART_HandleTypeDef *huart, uint16_t Size)
{
	if(huart->Instance == USART2){
		recieve_flag = 1;

		size_recieved = Size;
	}
}
/* USER CODE END 4 */
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
