Medokin8/Projekt_Zespolowy_Robot_Zwiadowczy/Programisci/ProjektZespolowy/Core/Inc/main.h

#define B1_Pin GPIO_PIN_13
#define B1_GPIO_Port GPIOC
#define LD1_Pin GPIO_PIN_0
#define LD1_GPIO_Port GPIOB
#define RESETG0_Pin GPIO_PIN_0
#define RESETG0_GPIO_Port GPIOG
#define PWDNPG1_Pin GPIO_PIN_1
#define PWDNPG1_GPIO_Port GPIOG
#define MOTOR_1_PWM_Pin GPIO_PIN_9
#define MOTOR_1_PWM_GPIO_Port GPIOE
#define MOTOR_1_GPIO_1_Pin GPIO_PIN_10
#define MOTOR_1_GPIO_1_GPIO_Port GPIOE
#define MOTOR_2_PWM_Pin GPIO_PIN_11
#define MOTOR_2_PWM_GPIO_Port GPIOE
#define MOTOR_1_GPIO_2_Pin GPIO_PIN_12
#define MOTOR_1_GPIO_2_GPIO_Port GPIOE
#define MOTOR_2_GPIO_1_Pin GPIO_PIN_15
#define MOTOR_2_GPIO_1_GPIO_Port GPIOE
#define MOTOR_2_GPIO_2_Pin GPIO_PIN_11
#define MOTOR_2_GPIO_2_GPIO_Port GPIOB
#define LD3_Pin GPIO_PIN_14
#define LD3_GPIO_Port GPIOB
#define STLINK_RX_Pin GPIO_PIN_8
#define STLINK_RX_GPIO_Port GPIOD
#define STLINK_TX_Pin GPIO_PIN_9
#define STLINK_TX_GPIO_Port GPIOD
#define USB_OTG_FS_PWR_EN_Pin GPIO_PIN_10
#define USB_OTG_FS_PWR_EN_GPIO_Port GPIOD
#define USB_OTG_FS_OVCR_Pin GPIO_PIN_7
#define USB_OTG_FS_OVCR_GPIO_Port GPIOG
