Medokin8/Projekt_Zespolowy_Robot_Zwiadowczy/Programisci/ProjektZespolowy/Core/Inc/camera_inittable.h

/*
 * camera_inittable.h
 *
 */

#ifndef INC_CAMERA_INITTABLE_H_
#define INC_CAMERA_INITTABLE_H_

#include "camera.h"

const char OV2640_YUV422[][2] =
{
		{ 0xFF, 0x00 },
		{ 0x05, 0x00 },
		{ 0xDA, 0x10 },
		{ 0xD7, 0x03 },
		{ 0xDF, 0x00 },
		{ 0x33, 0x80 },
		{ 0x3C, 0x40 },
		{ 0xe1, 0x77 },
		{ 0x00, 0x00 },
};

const char OV2640_JPEG[][2] =
{
		{ 0xe0, 0x14 },
		{ 0xe1, 0x77 },
		{ 0xe5, 0x1f },
		{ 0xd7, 0x03 },
		{ 0xda, 0x10 },
		{ 0xe0, 0x00 },
		{ 0xFF, 0x01 },
		{ 0x04, 0x08 },
		{ 0xff, 0xff }
};

const char OV2640_JPEG_INIT[][2] =
{
		{ 0xff, 0x00 },
		{ 0x2c, 0xff },
		{ 0x2e, 0xdf },
		{ 0xff, 0x01 },
		{ 0x3c, 0x32 },
		{ 0x11, 0x00 },
		{ 0x09, 0x02 },
		{ 0x04, 0x28 },
		{ 0x13, 0xe5 },
		{ 0x14, 0x48 },
		{ 0x2c, 0x0c },
		{ 0x33, 0x78 },
		{ 0x3a, 0x33 },
		{ 0x3b, 0xfB },
		{ 0x3e, 0x00 },
		{ 0x43, 0x11 },
		{ 0x16, 0x10 },
		{ 0x39, 0x92 },
		{ 0x35, 0xda },
		{ 0x22, 0x1a },
		{ 0x37, 0xc3 },
		{ 0x23, 0x00 },
		{ 0x34, 0xc0 },
		{ 0x36, 0x1a },
		{ 0x06, 0x88 },
		{ 0x07, 0xc0 },
		{ 0x0d, 0x87 },
		{ 0x0e, 0x41 },
		{ 0x4c, 0x00 },
		{ 0x48, 0x00 },
		{ 0x5B, 0x00 },
		{ 0x42, 0x03 },
		{ 0x4a, 0x81 },
		{ 0x21, 0x99 },
		{ 0x24, 0x40 },
		{ 0x25, 0x38 },
		{ 0x26, 0x82 },
		{ 0x5c, 0x00 },
		{ 0x63, 0x00 },
		{ 0x61, 0x70 },
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
};


/* resolutions 320x240 */
const char OV2640_320x240_JPEG[][2] =
{
		{ 0xff, 0x01 },
		{ 0x12, 0x40 },
		{ 0x17, 0x11 },
		{ 0x18, 0x43 },
		{ 0x19, 0x00 },
		{ 0x1a, 0x4b },
		{ 0x32, 0x09 },
		{ 0x4f, 0xca },
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
		  {0x46, 0x3f},
		  {0x0c, 0x3c},
		  {0x61, 0x70},
		  {0x62, 0x80},
		  {0x7c, 0x05},
		  {0x20, 0x80},
		  {0x28, 0x30},
		  {0x6c, 0x00},
		  {0x6d, 0x80},
		  {0x6e, 0x00},
		  {0x70, 0x02},
		  {0x71, 0x94},
		  {0x73, 0xc1},
		  {0x3d, 0x34},
		  {0x5a, 0x57},
		  {0x12, 0x00},
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
};

/* QVGA resolution 320x240 */
const char OV2640_QVGA[][2]=
{
		  {0xff, 0x00},
		  {0x2c, 0xff},
		  {0x2e, 0xdf},
		  {0xff, 0x01},
		  {0x3c, 0x32},
		  {0x11, 0x00},
		  {0x09, 0x02},
		  {0x04, 0xA8},
		  {0x13, 0xe5},
		  {0x14, 0x48},
		  {0x2c, 0x0c},
		  {0x33, 0x78},
		  {0x3a, 0x33},
		  {0x3b, 0xfB},
		  {0x3e, 0x00},
		  {0x43, 0x11},
		  {0x16, 0x10},
		  {0x4a, 0x81},
		  {0x21, 0x99},
		  {0x24, 0x40},
		  {0x25, 0x38},
		  {0x26, 0x82},
		  {0x5c, 0x00},
		  {0x63, 0x00},
		  {0x46, 0x3f},
		  {0x0c, 0x3c},
		  {0x61, 0x70},
		  {0x62, 0x80},
		  {0x7c, 0x05},
		  {0x20, 0x80},
		  {0x28, 0x30},
		  {0x6c, 0x00},
		  {0x6d, 0x80},
		  {0x6e, 0x00},
		  {0x70, 0x02},
		  {0x71, 0x94},
		  {0x73, 0xc1},
		  {0x3d, 0x34},
		  {0x5a, 0x57},
		  {0x12, 0x00},
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
};
#endif /* INC_CAMERA_INITTABLE_H_ */
