Medokin8/Projekt_Zespolowy_Robot_Zwiadowczy/(commit log)

2022-04-10 v0.1.0
    dodano:
    -schemat połączeń elektronicznych
    -projekt płytki pcb
    [projekt_zespołowy.kicad_pcb, projekt_zespołowy.sch]
2022-06-01 kod stm32
2022-06-05 schemat końcowy
    [projekt_zespołowy.kicad_pcb, projekt_zespołowy.sch]
