Medokin8/Projekt_Zespolowy_Robot_Zwiadowczy/(notices)

Notices in the files:
Programisci/ProjektZespolowy/Core/Src/main.c:
Copyright (c) 2022 STMicroelectronics.
All rights reserved.
This software is licensed under terms that can be found in the LICENSE file
